TheCacophonyProject/pi-hat/fab/0.4/photo_2019-05-05_12-32-07.jpg

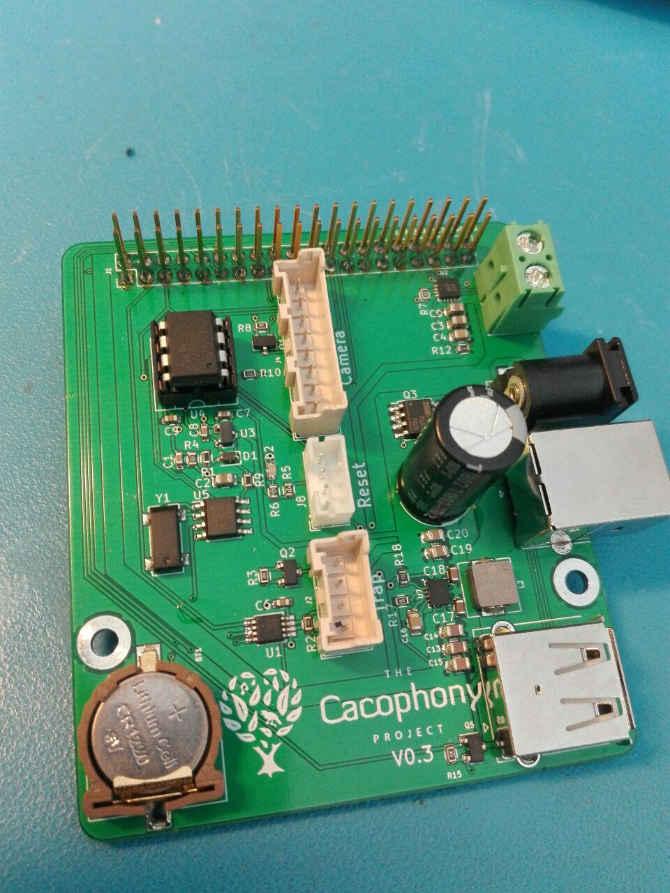
fab/0.4/photo_2019-05-05_12-32-07.jpg
