TheCacophonyProject/pi-hat/Cacophony_land_largeT2.jpg

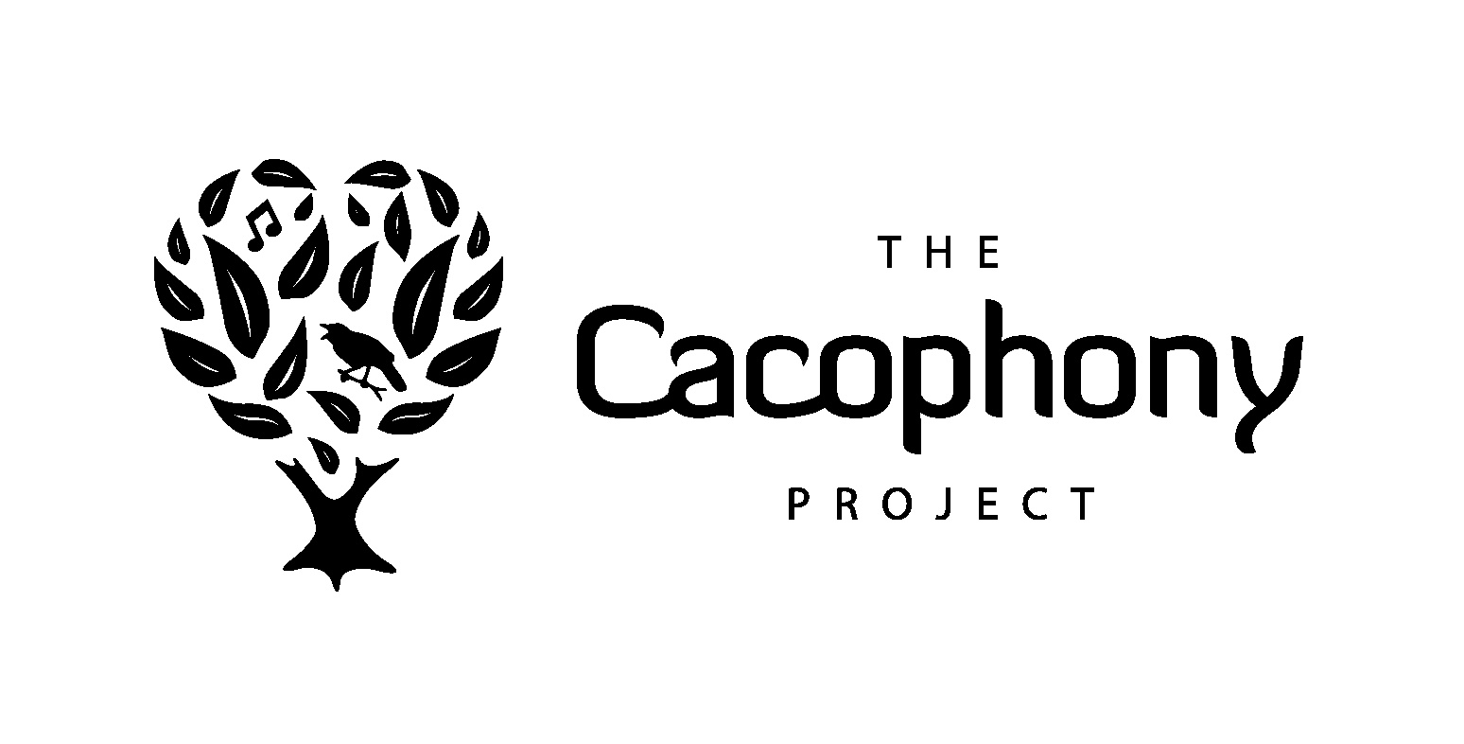
Cacophony_land_largeT2.jpg
