TheCacophonyProject/pi-hat/pi-hat.xlsx

Ref | Qty | Value | Footprint | Digikey | Link | MPN | OPL
BT1 | 1 | 1220 | pi-hat-footprints:CR1220 | BC501SM-ND | https://www.digikey.com/product-detail/en/mpd-memory-protection-devices/BC501SM/BC501SM-ND/2439260 | BC501SM
C3 C5 C2 C20 C19 | 5 | 10uF | Capacitors_SMD:C_0805 | 1276-2891-1-ND | https://www.digikey.com/product-detail/en/samsung-electro-mechanics/CL21A106KAYNNNE/1276-2891-1-ND/3890977 | CL21A106KAYNNNE | CC0805KKX5R8BB106
C4 C16 | 2 | 100nF | Capacitors_SMD:C_0805 | 720-1756-1-ND | https://www.digikey.com/product-detail/en/vishay-vitramon/VJ0805Y104MXXAT/720-1756-1-ND/8324176 | VJ0805Y104MXXAT | CC0805KRX7R9BB104
C6 C1 C9 C8 C7 | 5 | 2.2uF | Capacitors_SMD:C_0603 | 1276-1040-1-ND | https://www.digikey.com/product-detail/en/samsung-electro-mechanics/CL10A225KO8NNNC/1276-1040-1-ND/3889126 | CL10A225KO8NNNC
C11 | 1 | 820uF | Capacitors_THT:CP_Radial_D10.0mm_P5.00mm | 1189-2915-ND | https://www.digikey.com/product-detail/en/rubycon/25ZLH820MEFC10X20/1189-2915-ND/3563817 | 25ZLH820MEFC10X20
C18 C17 | 2 | 10uF | Capacitors_SMD:C_0603 | 490-7202-1-ND | https://www.digikey.com/product-detail/en/murata-electronics-north-america/GRM188R61E106MA73D/490-7202-1-ND/3900486 | GRM188R61E106MA73D | CC0603KRX5R6BB106
C13 C14 C15 | 3 | 22uF | Capacitors_SMD:C_0805 | 490-12389-1-ND | https://www.digikey.com/product-detail/en/murata-electronics-north-america/GRT21BR61E226ME13L/490-12389-1-ND/5417090 | GRT21BR61E226ME13L | CL21A226MQQNNNE
D2 | 1 | LED_RED | LEDs:LED_0603 | 511-1580-1-ND | https://www.digikey.com/product-detail/en/rohm-semiconductor/SML-D12U8WT86/511-1580-1-ND/1641812 | SML-D12U8WT86
D1 | 1 | D_Zener | Diodes_SMD:D_SOD-323 | MM3Z5V6ST1GOSCT-ND | https://www.digikey.com/product-detail/en/on-semiconductor/MM3Z5V6ST1G/MM3Z5V6ST1GOSCT-ND/964548 | MM3Z5V6ST1G
F1 | 1 | Fuse | Resistors_SMD:R_0603_HandSoldering | P15125CT-ND | https://www.digikey.com/product-detail/en/panasonic-electronic-components/ERB-RE5R00V/P15125CT-ND/2796832 | ERB-RE5R00V
J1 | 1 | Raspberry_Pi_2_3 | Pin_Headers:Pin_Header_Straight_2x20_Pitch2.54mm | SAM8767-ND | https://www.digikey.com/products/en?keywords=SAM8767-ND | ESQ-120-14-G-D
J4 | 1 | Conn_01x08 | Connectors_JST:JST_XH_B08B-XH-A_08x2.50mm_Straight | 455-1998-ND | https://www.digikey.com/product-detail/en/jst-sales-america-inc/B08B-XASK-1-LF-SN/455-1998-ND/1634739 | B08B-XASK-1(LF)(SN)
J7 | 1 | USB_OUT | Connector_USB:USB_A_Horizontal | ED2989-ND | https://www.digikey.com/product-detail/en/on-shore-technology-inc/USB-A1HSW6/ED2989-ND/2677750 | USB-A1HSW6 | ST-USB-003A
J5 | 1 | USB_B | Connector_USB:USB_B_Horizontal | ED2983-ND | https://www.digikey.com/product-detail/en/on-shore-technology-inc/USB-B1HSB6/ED2983-ND/2677744 | USB-B1HSB6
J6 | 1 | Conn_01x02 | Connectors:bornier2 | 277-1667-ND | https://www.digikey.com/product-detail/en/phoenix-contact/1935161/277-1667-ND/568614 | 1935161 | 1725656
J8 | 1 | Conn_01x04 | Connectors_JST:JST_PH_B4B-PH-K_04x2.00mm_Straight | 455-1706-ND | https://www.digikey.com/product-detail/en/jst-sales-america-inc/B4B-PH-K-S-LF-SN/455-1706-ND/926613 | B4B-PH-K-S(LF)(SN)
J2 | 1 | Conn_01x04 | Connectors_JST:JST_XH_B04B-XH-A_04x2.50mm_Straight | 455-1994-ND | https://www.digikey.com/product-detail/en/jst-sales-america-inc/B04B-XASK-1-LF-SN/455-1994-ND/1634735 | B04B-XASK-1(LF)(SN)
J3 | 1 | Jack-DC | Connectors:BARREL_JACK | CP-002A-ND | https://www.digikey.com/product-detail/en/cui-inc/PJ-002A/CP-002A-ND/96962 | PJ-002A | DC-005
L2 | 1 | 1.5uH | pi-hat-footprints:ETQP3MxxxKVP | P19760CT-ND | https://www.digikey.com/product-detail/en/panasonic-electronic-components/ETQ-P3M1R5KVP/P19760CT-ND/6134813 | ETQ-P3M1R5KVP
Q1 Q5 Q2 | 3 | Q_NMOS_GSD | TO_SOT_Packages_SMD:SOT-23 | 785-1009-1-ND | https://www.digikey.com/product-detail/en/alpha-omega-semiconductor-inc/AO3414/785-1009-1-ND/1855951 | AO3414
Q3 | 1 | Q_PMOS_DGS | digikey-footprints:IRF9310PbF | IRF9310TRPBFCT-ND | https://www.digikey.com/products/en?keywords=IRF9310TRPBFCT-ND | IRF9310TRPBF
R8 R15 R7 R3 R17 R10 | 6 | 100K | Resistors_SMD:R_0603 | RR08P100KDCT-ND | https://www.digikey.com/product-detail/en/susumu/RR0816P-104-D/RR08P100KDCT-ND/432772 | RR0816P-104-D
R12 | 1 | 634K | Resistors_SMD:R_0603 | 541-634KHCT-ND | https://www.digikey.com/product-detail/en/vishay-dale/CRCW0603634KFKEA/541-634KHCT-ND/1180130 | CRCW0603634KFKEA
R2 | 1 | 120R | Resistors_SMD:R_0603 | 1276-4566-1-ND | https://www.digikey.com/product-detail/en/samsung-electro-mechanics/RC1608F121CS/1276-4566-1-ND/3967538 | RC1608F121CS
R6 R5 | 2 | 470R | Resistors_SMD:R_0603 | 311-470HRCT-ND | https://www.digikey.com/product-detail/en/yageo/RC0603FR-07470RL/311-470HRCT-ND/730203 | RC0603FR-07470RL | RC0603JR-07470RL
R1 R9 | 2 | 1K | Resistors_SMD:R_0603 | P1.00KHCT-ND | https://www.digikey.com/product-detail/en/panasonic-electronic-components/ERJ-3EKF1001V/P1.00KHCT-ND/198071 | ERJ-3EKF1001V | RC0603JR-071KL
R4 R18 | 2 | 10K | Resistors_SMD:R_0603 | A126394CT-ND | https://www.digikey.com/product-detail/en/te-connectivity-passive-product/CRGH0603J10K/A126394CT-ND/7603449 | CRGH0603J10K | SMD RES 10K-5%-1/10W
U2 | 1 | MAX98357 | Housings_DFN_QFN:QFN-16-1EP_3x3mm_Pitch0.5mm | MAX98357AETE+TCT-ND | https://www.digikey.com/product-detail/en/maxim-integrated/MAX98357AETE-T/MAX98357AETE-TCT-ND/7603777 | MAX98357AETE+T
U1 | 1 | MAX485E | Housings_SSOP:MSOP-8_3x3mm_Pitch0.65mm | MAX3471CUA+-ND | https://www.digikey.com/product-detail/en/maxim-integrated/MAX3471CUA-/MAX3471CUA--ND/1702211 | MAX3471CUA+
U4 | 1 | ATTINY85-20SU | Housings_DIP:DIP-8_W7.62mm_Socket | AE9986-ND | https://www.digikey.com/product-detail/en/assmann-wsw-components/A-08-LC-TT/AE9986-ND/821740 | A 08-LC-TT
U5 | 1 | PCF8523 | Housings_SOIC:SOIC-8_3.9x4.9mm_Pitch1.27mm | 568-5306-1-ND | https://www.digikey.com/product-detail/en/nxp-usa-inc/PCF8523T-1 118/568-5306-1-ND/2530784 | PCF8523T/1 118
U7 | 1 | TPS630701 | pi-hat-footprints:TPS63070 | 296-44765-1-ND | https://www.digikey.com/product-detail/en/texas-instruments/TPS630701RNMT/296-44765-1-ND/6193752 | TPS630701RNMT
U3 | 1 | AP2210N-3.3TRG1 | TO_SOT_Packages_SMD:SOT-23 | AP2210N-3.3TRG1DICT-ND | https://www.digikey.com/product-detail/en/diodes-incorporated/AP2210N-3.3TRG1/AP2210N-3.3TRG1DICT-ND/4505294 | AP2210N-3.3TRG1
Y1 | 1 | 32.768 | Crystals:Crystal_SMD_SeikoEpson_MC306-4pin_8.0x3.2mm | 535-10240-1-ND | https://www.digikey.com/product-detail/en/abracon-llc/ABS25-32.768KHZ-6-T/535-10240-1-ND/2218053 | ABS25-32.768KHZ-6-T
