TheCacophonyProject/pi-hat/seeed.xlsx

Designator | Qty | Link | MPN/Seeed SKU
BT2 | 1 | https://www.digikey.com/product-detail/en/mpd-memory-protection-devices/BC501SM/BC501SM-ND/2439260 | BC501SM
C3 C5 C20 C19 C12 C1 C2 | 7 | https://www.digikey.com/product-detail/en/samsung-electro-mechanics/CL21A106KAYNNNE/1276-2891-1-ND/3890977 | CC0805KKX5R8BB106
C4 C16 | 2 | https://www.digikey.com/product-detail/en/vishay-vitramon/VJ0805Y104MXXAT/720-1756-1-ND/8324176 | CC0805KRX7R9BB104
C11 | 1 | https://www.digikey.com/product-detail/en/rubycon/25ZLH820MEFC10X20/1189-2915-ND/3563817 | 25ZLH820MEFC10X20
C18 C17 | 2 | https://www.digikey.com/product-detail/en/tdk-corporation/C1608JB1E106M080AC/445-11238-1-ND/3952904 | CC0603KRX5R6BB106
C13 C14 C15 | 3 | https://www.digikey.com/product-detail/en/murata-electronics-north-america/GRT21BR61E226ME13L/490-12389-1-ND/5417090 | CL21A226MQQNNNE
D2 | 1 | https://www.digikey.com/product-detail/en/lite-on-inc/LTST-C191KGKT/160-1446-1-ND/386834 | LTST-C191KGKT
D3 | 1 | https://www.digikey.com/product-detail/en/on-semiconductor/MM3Z4V3B/MM3Z4V3BCT-ND/1626891 | MM3Z4V3B
J1 | 1 | https://www.digikey.com/product-detail/en/sullins-connector-solutions/PPTC202LFBN-RC/S6104-ND/807240 | PPTC202LFBN-RC
J4 | 1 | https://www.digikey.com/product-detail/en/jst-sales-america-inc/B8B-XH-A(LF)(SN)/455-2251-ND/1651049 | B8B-XH-A(LF)(SN)
J7 | 1 | https://www.digikey.com/product-detail/en/on-shore-technology-inc/USB-A1HSW6/ED2989-ND/2677750 | ST-USB-003A
J5 | 1 | https://www.digikey.com/product-detail/en/on-shore-technology-inc/USB-B1HSB6/ED2983-ND/2677744 | USB-B1HSB6
J6 | 1 | https://www.digikey.com/product-detail/en/phoenix-contact/1935161/277-1667-ND/568614 | 1725656
J3 | 1 | https://www.digikey.com/product-detail/en/cui-inc/PJ-002A/CP-002A-ND/96962 | DC-005
L2 | 1 | https://www.digikey.com/product-detail/en/panasonic-electronic-components/ETQ-P3M1R5KVP/P19760CT-ND/6134813 | ETQ-P3M1R5KVP
Q1 Q5 | 2 | https://www.digikey.com/product-detail/en/alpha-omega-semiconductor-inc/AO3422/785-1015-1-ND/1855957 | AO3422
Q3 | 1 | https://www.digikey.com/product-detail/en/on-semiconductor/NTF3055L108T1G/NTF3055L108T1GOSCT-ND/921563 | NTF3055L108T1G
R8 R15 R7 R9 R17 | 5 | https://www.digikey.com/product-detail/en/susumu/RR0816P-104-D/RR08P100KDCT-ND/432772 | RC0603JR-07100KL
R12 | 1 | https://www.digikey.com/product-detail/en/vishay-dale/CRCW0603634KFKEA/541-634KHCT-ND/1180130 | CRCW0603634KFKEA
R6 | 1 | https://www.digikey.com/product-detail/en/yageo/RC0603FR-07470RL/311-470HRCT-ND/730203 | RC0603JR-07470RL
R18 R4 | 2 | https://www.digikey.com/product-detail/en/te-connectivity-passive-product/CRGH0603J10K/A126394CT-ND/7603449 | SMD RES 10K-5%-1/10W
R16 R1 | 2 | https://www.digikey.com/product-detail/en/panasonic-electronic-components/ERJ-3EKF1001V/P1.00KHCT-ND/198071 | RC0603JR-071KL
U2 | 1 | https://www.digikey.com/product-detail/en/maxim-integrated/MAX98357AETE-T/MAX98357AETE-TCT-ND/7603777 | MAX98357AETE+T
U5 | 1 | https://www.digikey.com/product-detail/en/assmann-wsw-components/A-08-LC-TT/AE9986-ND/821740 | A 08-LC-TT
U7 | 1 | https://www.digikey.com/product-detail/en/texas-instruments/TPS630701RNMT/296-44765-1-ND/6193752 | TPS630701RNMT
U6 | 1 | https://www.digikey.com/product-detail/en/nxp-usa-inc/PCF8523T-1 118/568-5306-1-ND/2530784 | PCF8523T/1 118
Y2 | 1 | https://www.digikey.com/product-detail/en/abracon-llc/ABS25-32.768KHZ-6-T/535-10240-1-ND/2218053 | ABS25-32.768KHZ-6-T
