TheCacophonyProject/pi-hat/fab/0.4/drawing.pdf

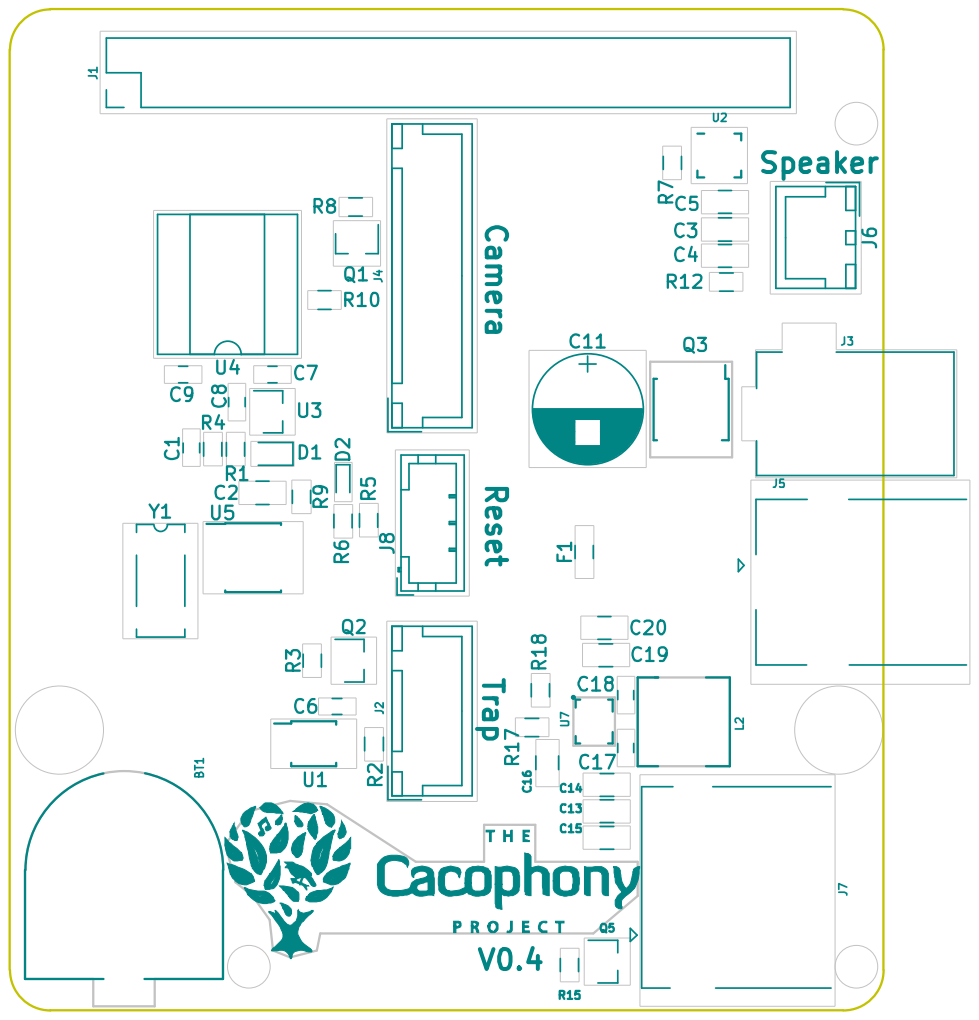
[picture p3: page 1]
