TheCacophonyProject/pi-hat/pi-hat.kicad_pcb

## KiCad design pi-hat.kicad_pcb (2019-05-20)

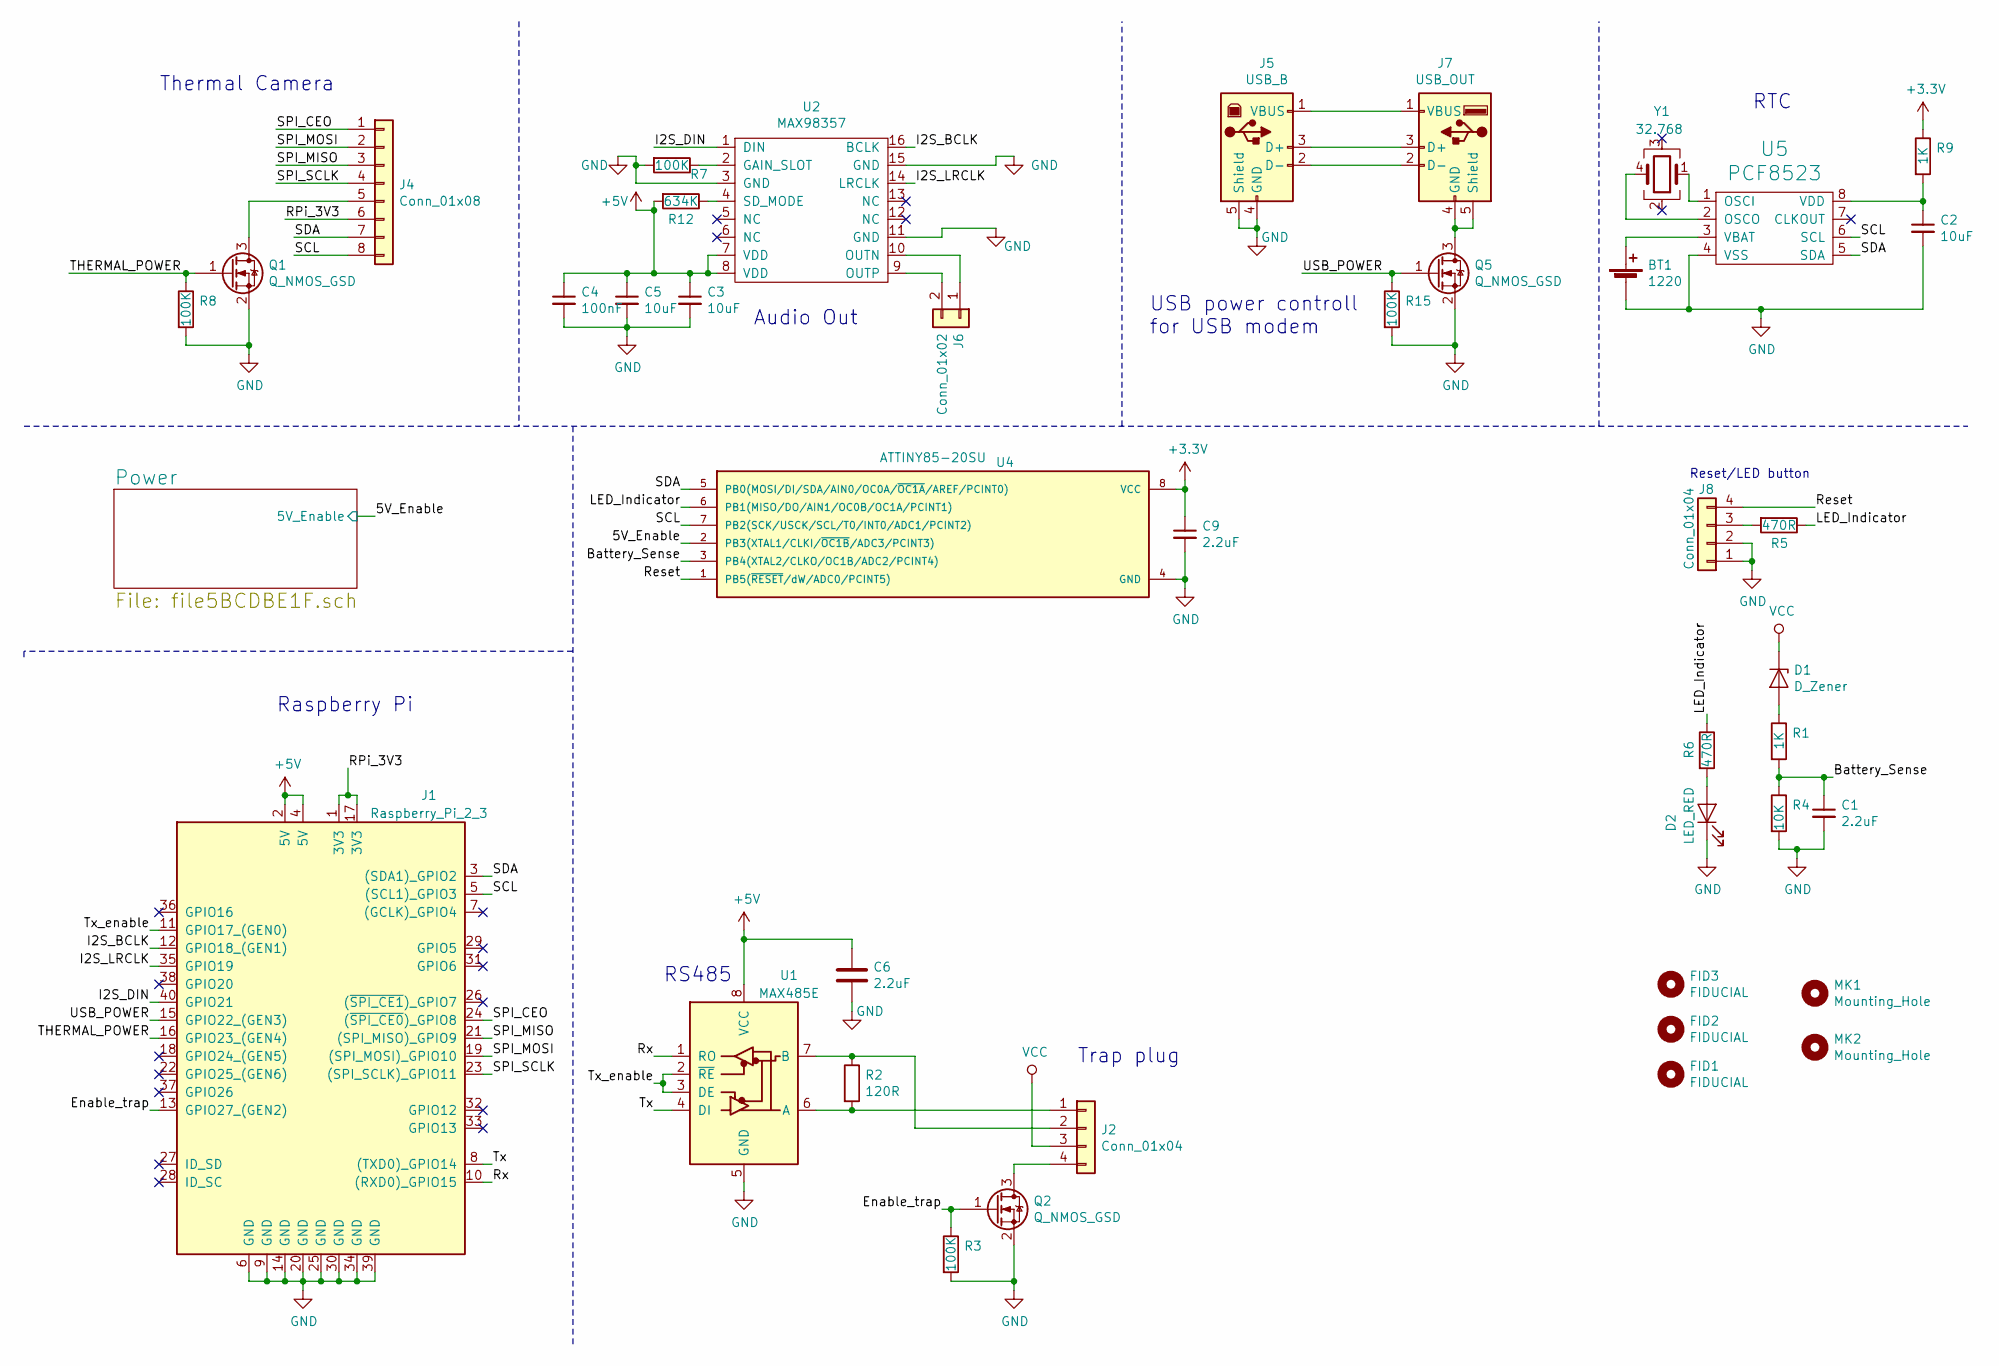
[picture p4: schematic pi-hat.sch]

Parts:
BT1: 1220; CR1220; MPN BC501SM; Digikey BC501SM-ND
C1, C6, C9: 2.2uF; C_0603; MPN CL10A225KO8NNNC; Digikey 1276-1040-1-ND
C2, C3, C5: 10uF; C_0805; MPN CL21A106KAYNNNE; Digikey 1276-2891-1-ND
C4: 100nF; C_0805; MPN VJ0805Y104MXXAT; Digikey 720-1756-1-ND
D1: D_Zener; D_SOD-323; MPN MM3Z5V6ST1G; Digikey MM3Z5V6ST1GOSCT-ND
D2: LED_RED; LED_0603; MPN SML-D12U8WT86; Digikey 511-1580-1-ND
FID1, FID2, FID3: FIDUCIAL; Fiducial_1mm_Dia_2.54mm_Outer_CopperTop
J1: Raspberry_Pi_2_3; Pin_Header_Straight_2x20_Pitch2.54mm; MPN ESQ-120-14-G-D; Digikey SAM8767-ND
J2: Conn_01x04; JST_XH_B04B-XH-A_04x2.50mm_Straight; MPN B04B-XASK-1(LF)(SN); Digikey 455-1994-ND
J4: Conn_01x08; JST_XH_B08B-XH-A_08x2.50mm_Straight; MPN B08B-XASK-1(LF)(SN); Digikey 455-1998-ND
J5: USB_B; USB_B_Horizontal; MPN USB-B1HSB6; Digikey ED2983-ND
J6: Conn_01x02; JST_XH_B02B-XH-A_02x2.50mm_Straight; MPN B02B-XASK-1(LF)(SN); Digikey 455-1989-ND
J7: USB_OUT; USB_A_Horizontal; MPN USB-A1HSW6; Digikey ED2989-ND
J8: Conn_01x04; JST_PH_B4B-PH-K_04x2.00mm_Straight; MPN B4B-PH-K-S(LF)(SN); Digikey 455-1706-ND
MK1, MK2: Mounting_Hole; MountingHole_3mm_Pad
Q1, Q2, Q5: Q_NMOS_GSD; SOT-23; MPN AO3414; Digikey 785-1009-1-ND
R1, R9: 1K; R_0603; MPN ERJ-3EKF1001V; Digikey P1.00KHCT-ND
R2: 120R; R_0603; MPN RC1608F121CS; Digikey 1276-4566-1-ND
R3, R7, R8, R15: 100K; R_0603; MPN RR0816P-104-D; Digikey RR08P100KDCT-ND
R4: 10K; R_0603; MPN CRGH0603J10K; Digikey A126394CT-ND
R5, R6: 470R; R_0603; MPN RC0603FR-07470RL; Digikey 311-470HRCT-ND
R12: 634K; R_0603; MPN CRCW0603634KFKEA; Digikey 541-634KHCT-ND
U1: MAX485E; MSOP-8_3x3mm_Pitch0.65mm; MPN MAX3471CUA+; Digikey MAX3471CUA+-ND
U2: MAX98357; QFN-16-1EP_3x3mm_Pitch0.5mm; MPN MAX98357AETE+T; Digikey MAX98357AETE+TCT-ND
U4: ATTINY85-20SU; DIP-8_W7.62mm_Socket; MPN A 08-LC-TT; Digikey AE9986-ND
U5: PCF8523; SOIC-8_3.9x4.9mm_Pitch1.27mm; MPN PCF8523T/1,118; Digikey 568-5306-1-ND
Y1: 32.768; Crystal_SMD_SeikoEpson_MC306-4pin_8.0x3.2mm; MPN ABS25-32.768KHZ-6-T; Digikey 535-10240-1-ND

Connections:
+3V3: C9.1, R9.1, U4.8 (VCC); also elsewhere on the board
+5V: C3.1, C4.1, C5.1, C6.1, J1.2 (5V), J1.4 (5V), R12.2, U1.8 (VCC), U2.7 (VDD), U2.8 (VDD); also elsewhere on the board
/5V_Enable: U4.2 (PB3(XTAL1/CLKI/~OC1B~/ADC3/PCINT3)); also elsewhere on the board
/Battery_Sense: C1.1, R1.2, R4.1, U4.3 (PB4(XTAL2/CLKO/OC1B/ADC2/PCINT4))
/Enable_trap: J1.13 (GPIO27_(GEN2)), Q2.1 (G), R3.1
/I2S_BCLK: J1.12 (GPIO18_(GEN1)), U2.16 (BCLK)
/I2S_DIN: J1.40 (GPIO21), U2.1 (DIN)
/I2S_LRCLK: J1.35 (GPIO19), U2.14 (LRCLK)
/LED_Indicator: R5.1, R6.1, U4.6 (PB1(MISO/DO/AIN1/OC0B/OC1A/PCINT1))
/RPi_3V3: J1.1 (3V3), J1.17 (3V3), J4.6
/Reset: J8.4, U4.1 (PB5(~RESET~/dW/ADC0/PCINT5))
/Rx: J1.10 ((RXD0)_GPIO15), U1.1 (RO)
/SCL: J1.5 ((SCL1)_GPIO3), J4.8, U4.7 (PB2(SCK/USCK/SCL/T0/INT0/ADC1/PCINT2)), U5.6 (SCL)
/SDA: J1.3 ((SDA1)_GPIO2), J4.7, U4.5 (PB0(MOSI/DI/SDA/AIN0/OC0A/~OC1A~/AREF/P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), U5.5 (SDA)
/SPI_CEO: J1.24 ((~SPI_CE0~)_GPIO8), J4.1
/SPI_MISO: J1.21 ((SPI_MISO)_GPIO9), J4.3
/SPI_MOSI: J1.19 ((SPI_MOSI)_GPIO10), J4.2
/SPI_SCLK: J1.23 ((SPI_SCLK)_GPIO11), J4.4
/THERMAL_POWER: J1.16 (GPIO23_(GEN4)), Q1.1 (G), R8.1
/Tx: J1.8 ((TXD0)_GPIO14), U1.4 (DI)
/Tx_enable: J1.11 (GPIO17_(GEN0)), U1.2 (~RE), U1.3 (DE)
/USB_POWER: J1.15 (GPIO22_(GEN3)), Q5.1 (G), R15.1
GND: BT1.2 (-), C1.2, C2.2, C3.2, C4.2, C5.2, C6.2, C9.2, D2.1 (K), J1.6 (GND), J1.9 (GND), J1.14 (GND), J1.20 (GND), J1.25 (GND), J1.30 (GND), J1.34 (GND), J1.39 (GND), J5.4 (GND), J5.5 (Shield), J8.1, J8.2, Q1.2 (S), Q2.2 (S), Q5.2 (S), R3.2, R4.2, R7.2, R8.2, R15.2, U1.5 (GND), U2.3 (GND), U2.11 (GND), U2.15 (GND), U4.4 (GND), U5.4 (VSS); also elsewhere on the board
unnamed: BT1.1 (+), U5.3 (VBAT)
unnamed: C2.1, R9.2, U5.8 (VDD)
unnamed: D1.2 (A), R1.1
unnamed: D2.2 (A), R6.2
unnamed: J2.1, R2.2, U1.6 (A)
unnamed: J2.2, R2.1, U1.7 (B)
unnamed: J2.4, Q2.3 (D)
unnamed: J4.5, Q1.3 (D)
unnamed: J5.1 (VBUS), J7.1 (VBUS)
unnamed: J5.2 (D-), J7.2 (D-)
unnamed: J5.3 (D+), J7.3 (D+)
unnamed: J6.1, U2.10 (OUTN)
unnamed: J6.2, U2.9 (OUTP)
unnamed: J7.4 (GND), J7.5 (Shield), Q5.3 (D)
unnamed: J8.3, R5.2
unnamed: R7.1, U2.2 (GAIN_SLOT)
unnamed: R12.1, U2.4 (SD_MODE)
unnamed: U5.1 (OSCI), Y1.1
unnamed: U5.2 (OSCO), Y1.4
VCC: D1.1 (K), J2.3; also elsewhere on the board

Notes on the sheet:
Raspberry Pi
Audio Out
Thermal Camera
USB power controll for USB modem
Reset/LED button
RTC
RS485
Trap plug

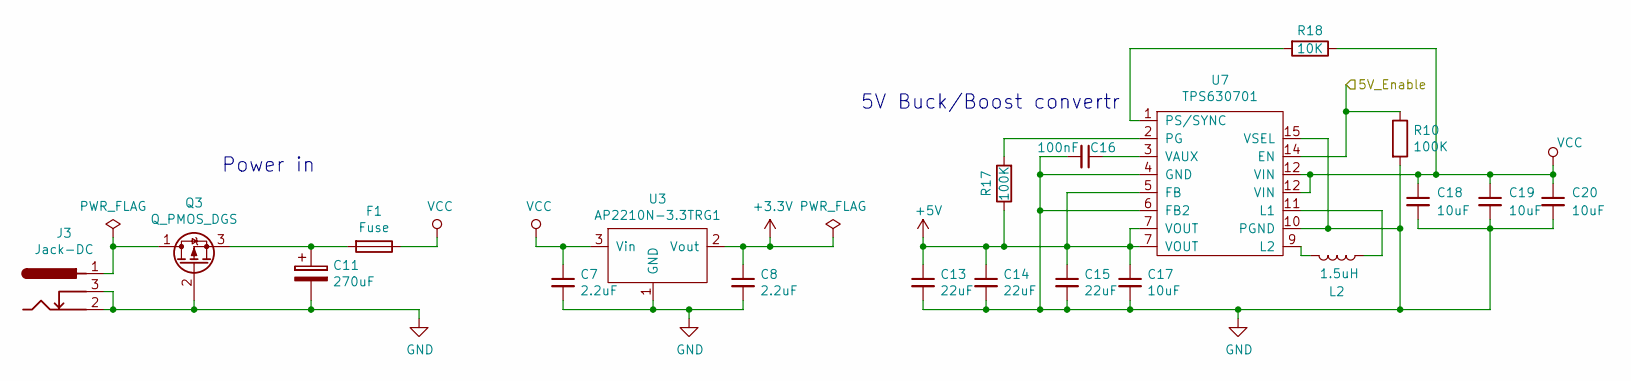
[picture p5: schematic file5BCDBE1F.sch]

Parts:
C7, C8: 2.2uF; C_0603; MPN CL10A225KO8NNNC; Digikey 1276-1040-1-ND
C11: 270uF; CP_Radial_D8.0mm_P3.50mm; MPN 25ZLH820MEFC10X20; Digikey 1189-2915-ND
C13, C14, C15: 22uF; C_0805; MPN GRT21BR61E226ME13L; Digikey 490-12389-1-ND
C16: 100nF; C_0805; MPN VJ0805Y104MXXAT; Digikey 720-1756-1-ND
C17, C18: 10uF; C_0603; MPN GRM188R61E106MA73D; Digikey 490-7202-1-ND
C19, C20: 10uF; C_0805; MPN CL21A106KAYNNNE; Digikey 1276-2891-1-ND
F1: Fuse; R_0603_HandSoldering; MPN ERB-RE5R00V; Digikey P15125CT-ND
J3: Jack-DC; BARREL_JACK; MPN PJ-002A; Digikey CP-002A-ND
L2: 1.5uH; ETQP3MxxxKVP; MPN ETQ-P3M1R5KVP; Digikey P19760CT-ND
Q3: Q_PMOS_DGS; IRF9310PbF; MPN IRF9310TRPBF; Digikey IRF9310TRPBFCT-ND
R10, R17: 100K; R_0603; MPN RR0816P-104-D; Digikey RR08P100KDCT-ND
R18: 10K; R_0603; MPN CRGH0603J10K; Digikey A126394CT-ND
U3: AP2210N-3.3TRG1; SOT-23; MPN AP2210N-3.3TRG1; Digikey AP2210N-3.3TRG1DICT-ND
U7: TPS630701; TPS63070; MPN TPS630701RNMT; Digikey 296-44765-1-ND

Connections:
+3V3: C8.1, U3.2 (Vout); also elsewhere on the board
+5V: C13.1, C14.1, C15.1, C17.1, R17.1, U7.5 (FB), U7.7 (VOUT); also elsewhere on the board
/5V_Enable: R10.1, U7.14 (EN); also elsewhere on the board
GND: C7.2, C8.2, C11.2, C13.2, C14.2, C15.2, C16.2, C17.2, C18.2, C19.2, C20.2, J3.2, J3.3, Q3.2 (G), R10.2, U3.1 (GND), U7.4 (GND), U7.6 (FB2), U7.10 (PGND), U7.15 (VSEL); also elsewhere on the board
unnamed: C11.1, F1.2, Q3.3 (S)
unnamed: C16.1, U7.3 (VAUX)
unnamed: J3.1, Q3.1 (D)
unnamed: L2.1, U7.11 (L1)
unnamed: L2.2, U7.9 (L2)
unnamed: R17.2, U7.2 (PG)
unnamed: R18.2, U7.1 (PS/SYNC)
VCC: C7.1, C18.1, C19.1, C20.1, F1.1, R18.1, U3.3 (Vin), U7.12 (VIN); also elsewhere on the board

Notes on the sheet:
5V Buck/Boost convertr
Power in

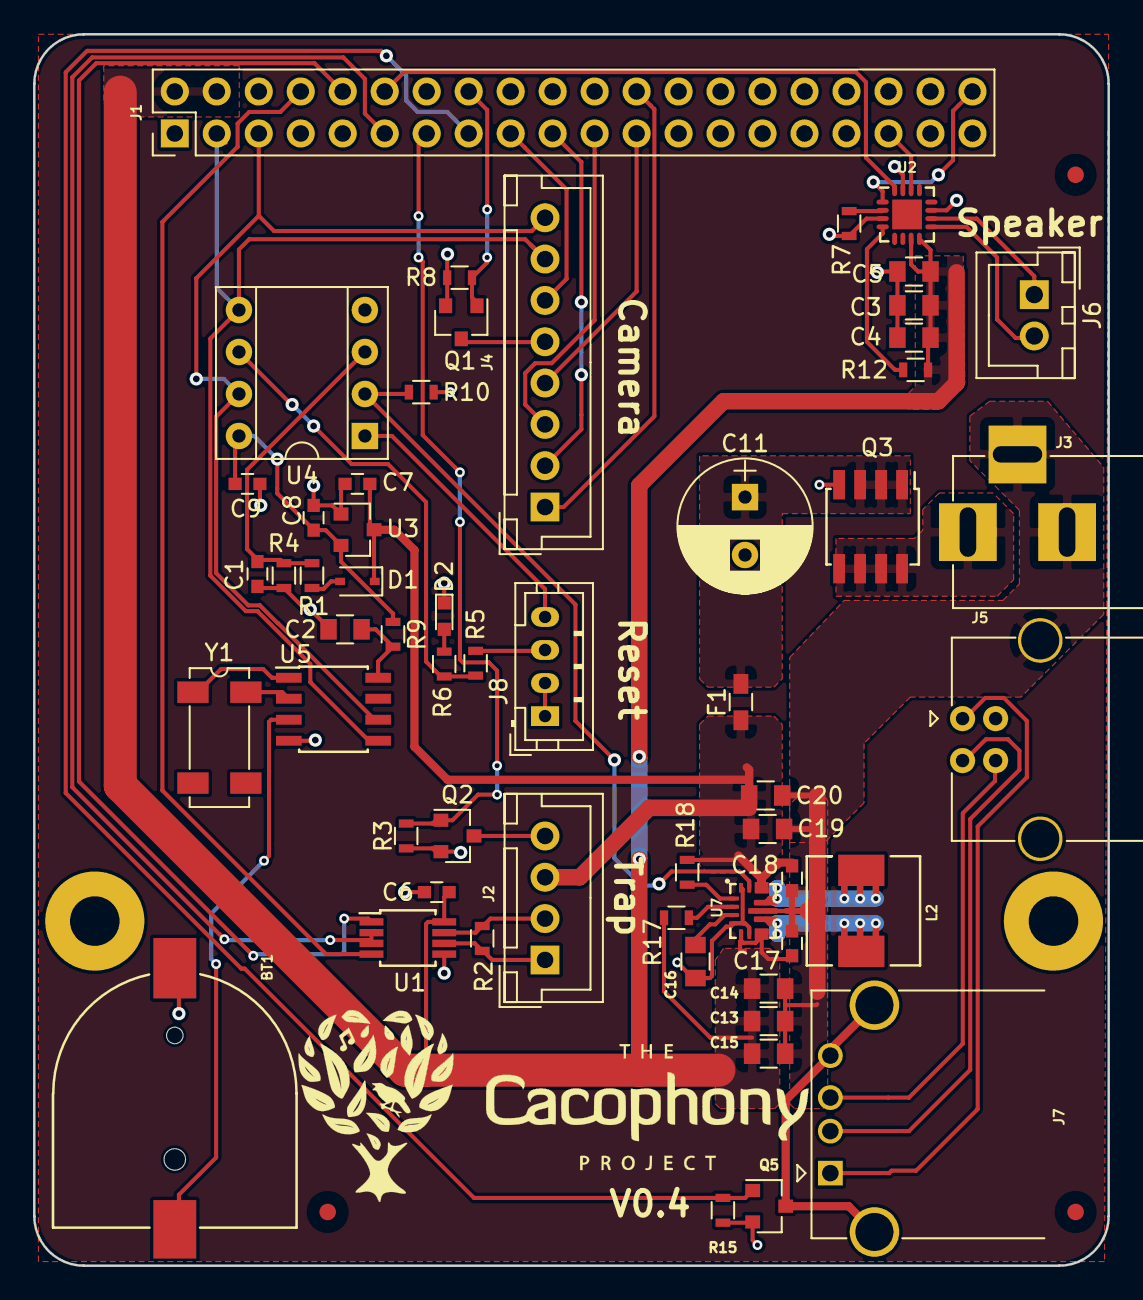
[picture p6: board pi-hat.kicad_pcb from above]

Board: 2 copper layers, 65.0 x 74.5 mm, 61 parts (0 on the bottom side), 50 nets.
