TheCacophonyProject/pi-hat/(commit log)

2018-07-08 updated pi hat to latest version.
    [file5BCDBE1F.sch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]
2018-07-17 renamed BOM file
    [pi-hat-bom.csv]
2018-07-20 deleted unused files and tidied up footprint librarys
    [file5BCDBE1F.sch]
2019-02-15 Added link, MPN, and Digikey number to all parts.
    [file5BCDBE1F.sch, pi-hat.sch]
2019-02-15 Added some Seeed OPL parts
    [file5BCDBE1F.sch, pi-hat.sch]
2019-03-21 Updated to version 0.3
    [file5BCDBE1F.sch, pi-hat.kicad_pcb, pi-hat.sch]
2019-05-20 Version 4
    [file5BCDBE1F.sch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]
